julia-du/Rhythm-Game/README.md

# Rhythm-Game
GitHub repository for the E155 MicroPs Final Project: Rhythm Game 

By Julia Du and Allison Tsai

December 8, 2023

- docs: Contains the files for the project website
- src: Contains the files for the source code and CAD
