julia-du/Rhythm-Game/src/README.md

# Project Source Code
This folder contains the source code for the project.
- FPGA
    - main.sv: SystemVerilog for the FPGA
    - pins.pdc: Pin mappings for the FPGA
    - LED Display Patterns: folder containing text files for the various patterns for the LED display
- CAD
    - LED-Display-Stand.sldprt/.stl: CAD of stand used for the LED display
    - Drum.sldprt/.x_t: CAD of the mechanical design of the drum
- MCU
    - main.c: C code for the MCU
    - lib files: folder containing source and header files for used peripherals and the beatmap
