julia-du/Rhythm-Game/docs/05_about.md

---
layout: page
title: About
permalink: /about
---

# Allison Tsai

[LinkedIn](https://www.linkedin.com/in/allison-tsai-08d11t/)

Senior mechanical/electrical engineering student at Harvey Mudd. Medical devices are cool •⏑•

# Julia Du

[GitHub](https://github.com/julia-du)

Senior engineering student at Harvey Mudd. Circuits <3 <3.

# Acknowledgement

We would like to thank Cole, Lilly, Chris, Hannah, and Jose, for helping test our game!
