julia-du/Rhythm-Game/docs/about.md

---
layout: page
title: About
---

TODO: short bios

# Allison Tsai
Links: [LinkedIn](link)

# Julia Du
Links: [GitHub](https://github.com/julia-du)

Senior engineering student at Harvey Mudd. 

Circuits <3 <3
