julia-du/Rhythm-Game/src/CAD/Drum.sldprt

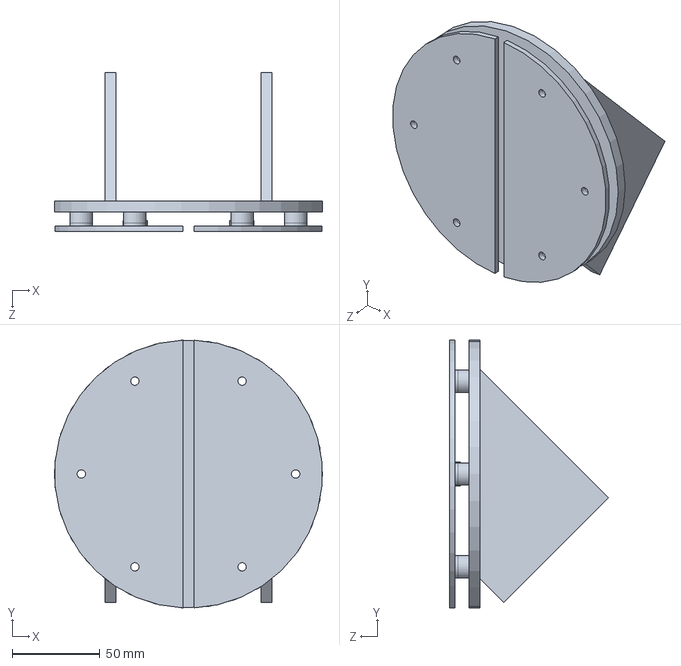
[picture p6: CAD file, 2023-12-07]
src/CAD/Drum.sldprt
152.4 x 152.3 x 90.5 mm
