julia-du/Rhythm-Game/src/CAD/LED-Display-Stand.SLDPRT

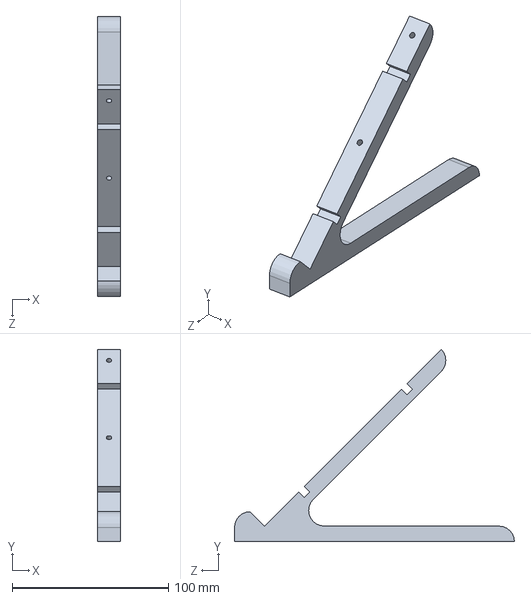
[picture p7: CAD file, 2023-12-04]
src/CAD/LED-Display-Stand.SLDPRT
15.0 x 123.1 x 179.2 mm
