julia-du/Rhythm-Game/(list of files, cad)

Other CAD files:
src/CAD/Drum.x_t
src/CAD/LED-Display-Stand.STL
