julia-du/Rhythm-Game/docs/03_results.md

---
layout: page
title: Results
permalink: /results
---

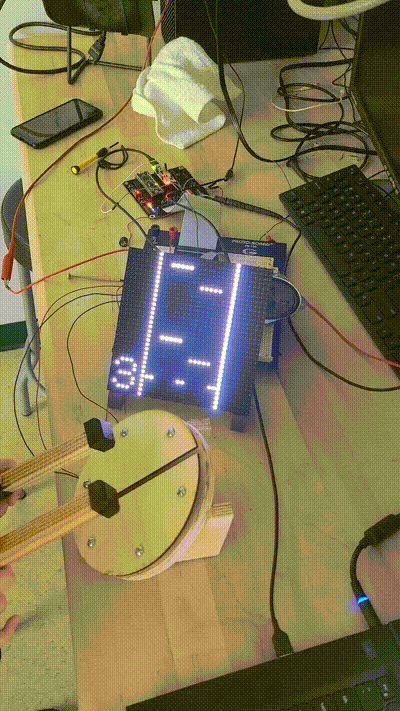
[picture p8: docs/assets/vid/win_demo.gif]
win_demo
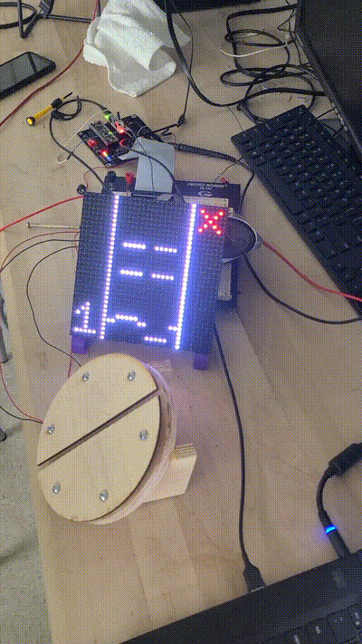
[picture p9: docs/assets/vid/game-over_demo.gif]
game-over_demo
 

# Results

All of the specs we noted in our project proposal were met. The MCU correctly plays the notes in tune and for the correct duration, sends the beats to the FPGA on time, and scores the hits from the user. This is consistent even when the length of each quarter note is only 1.13 seconds. The FPGA correctly displays the beats scrolling down, hits and misses, the round number, and the losing or winning screen without any visible flickering or bleeding. 

# Future Work

## MCU

In the current design, the piezo voltage is being regulated by a comparator circuit because the voltage can potentially spike up to 16V and break the MCU pin. While this circuit setup works fine, tuning the drum sensitivity must be done externally through hardware adjustments. To facilitate the tuning process, the comparator circuit can be changed to a buffer with 0 to +3.3V rails. This would allow sensitivity adjustments to be made through software instead of hardware. 

Additionally, there is small bug related to the user input. If the user barely hits the note on time, the MCU will register it as both a hit and miss. While this doesn't affect the user score, it does affect the display. The display quickly switches between the green hit and the red miss, which could be confusing to players. This issue may be caused by the looping logic. During testing, the code would print a large number of miss statements instead of one to the debug terminal even when there is only one "miss". This could mean that the MCU is checking for misses more than once per note.   

## FPGA

Currently, the FPGA interface to the 32 x 32 LED matrix display is mostly generic except for the colors of hits and misses. The rest of the display is only white or off. To allow for more customizable colors, the interface can be expanded to deal with RGB data. This would triple the amount of data the FPGA must deal with, which will likely require using the FPGA memory rather than using 1024-bit buses to the interface module.

The FPGA can also implement SPI to read data from the MCU rather than receiving all data through GPIO. Using SPI would allow for much more information to be received, such as the exact score a player earns for a given round, the high score for the current session, the accuracy of the player's hits, etc.
