julia-du/Rhythm-Game/(commit log)

2023-12-04 Started source code, outline for FPGA design
    [LED-Display-Stand.SLDPRT, LED-Display-Stand.STL]
2023-12-06 Added to index and FPGA, added schematic to documentation
2023-12-06 Fixed link for CAD
2023-12-07 Drum CAD files
    [Drum.sldprt, Drum.x_t]
2023-12-07 Edits
    1. made more updates to the MCU page
    2. added demo videos and gifs to a new folder in the assets folder
    3. updated heading in FPGA page
    4. updated MCU and results section in results page
    5. updated BOM
2023-12-07 update BOM
    added 1/8" plywood
